blinky-lite-archive/blinky-fridge-mon-cube/schematics/cubeSchem/blinky-refrig-mon-cube.kicad_pcb

## KiCad design schematics/cubeSchem/blinky-refrig-mon-cube.kicad_pcb (2022-01-05)

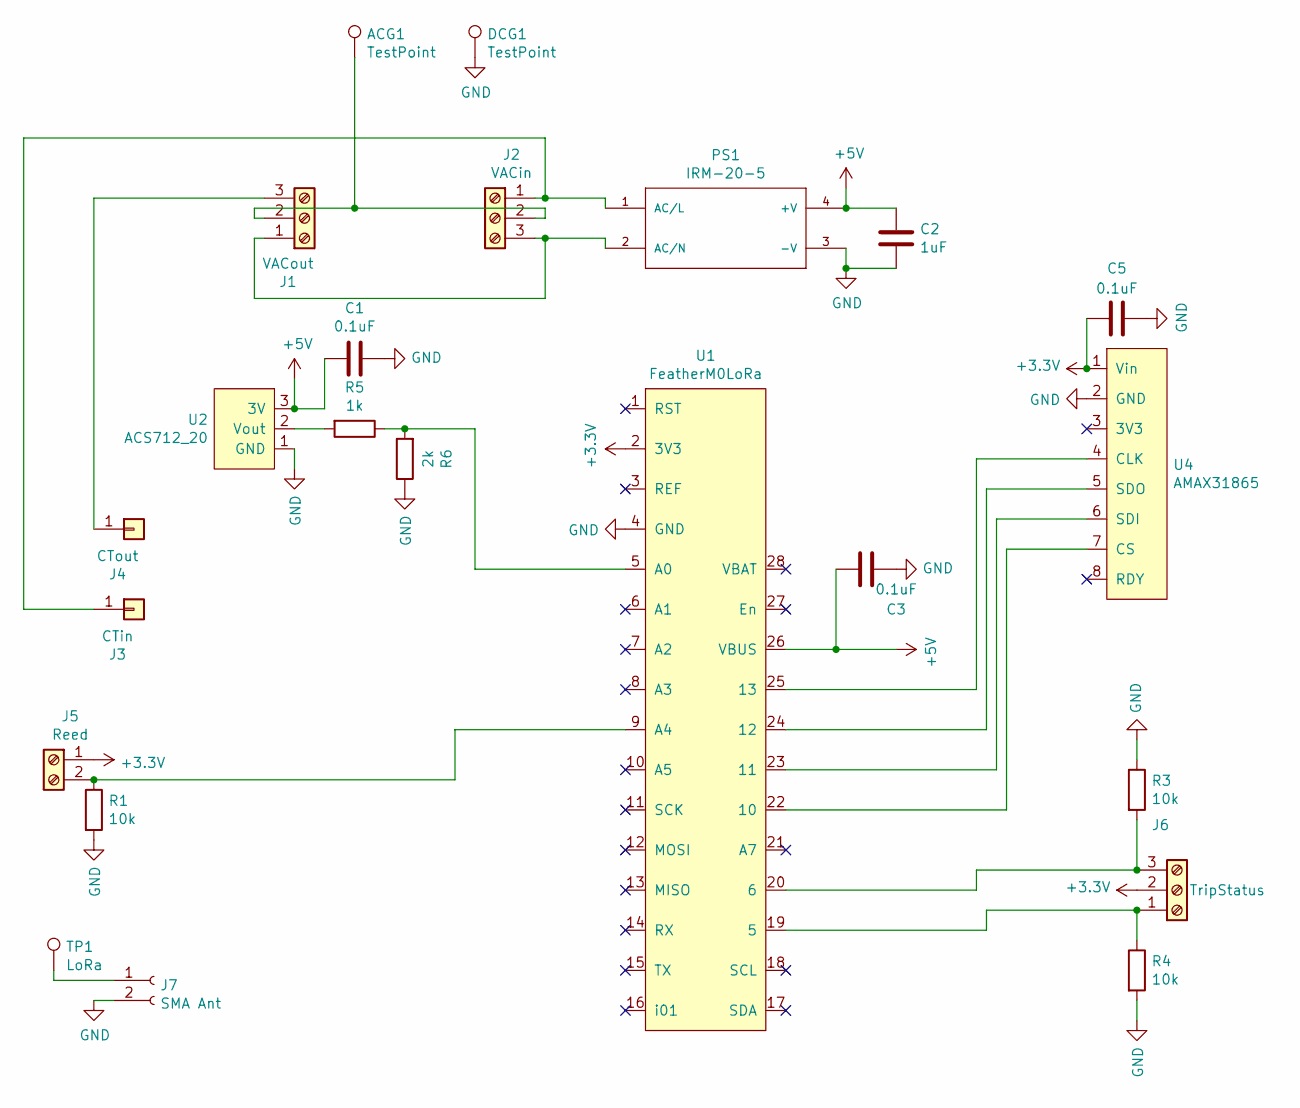
[picture p1: schematic blinky-refrig-mon-cube.sch]

Parts:
ACG1: TestPoint; TestPoint_THTPad_3.0x3.0mm_Drill1.5mm
C1, C3, C5: 0.1uF; C_1206_3216Metric_Pad1.42x1.75mm_HandSolder
C2: 1uF; C_1206_3216Metric_Pad1.42x1.75mm_HandSolder
DCG1: TestPoint; TestPoint_THTPad_3.0x3.0mm_Drill1.5mm
J1: VACout; TerminalBlock_bornier-3_P5.08mm
J2: VACin; TerminalBlock_bornier-3_P5.08mm
J3: CTin; SolderWirePad_1x01_Drill1.5mm
J4: CTout; SolderWirePad_1x01_Drill1.5mm
J5: Reed; TerminalBlock_bornier-2_P5.08mm
J6: TripStatus; TerminalBlock_bornier-3_P5.08mm
J7: SMA Ant; SMA_pcb
PS1: IRM-20-5; CONV_IRM-20-5
R1, R3, R4: 10k; R_1206_3216Metric_Pad1.42x1.75mm_HandSolder
R5: 1k; R_1206_3216Metric_Pad1.42x1.75mm_HandSolder
R6: 2k; R_1206_3216Metric_Pad1.42x1.75mm_HandSolder
TP1: LoRa; TestPoint_Plated_Hole_D2.0mm
U1: FeatherM0LoRa
U2: ACS712_20; ACS712_20A
U4: AMAX31865

Connections:
+3V3: C5.2, J5.1, J6.2, U1.2 (3V3), U4.1 (Vin)
+5V: C1.2, C2.1, C3.2, PS1.4 (+V), U1.26 (VBUS), U2.3 (3V)
GND: C1.1, C2.2, C3.1, C5.1, DCG1.1, J7.2, PS1.3 (-V), R1.2, R3.1, R4.2, R6.1, U1.4 (GND), U2.1 (GND), U4.2 (GND)
unnamed: ACG1.1, J1.2, J2.2
unnamed: J1.1, J2.3, PS1.2 (AC/N)
unnamed: J1.3, J4.1
unnamed: J2.1, J3.1, PS1.1 (AC/L)
unnamed: J5.2, R1.1, U1.9 (A4)
unnamed: J6.1, R4.1, U1.19 (5)
unnamed: J6.3, R3.2, U1.20 (6)
unnamed: J7.1, TP1.1
unnamed: R5.1, R6.2, U1.5 (A0)
unnamed: R5.2, U2.2 (Vout)
unnamed: U1.22 (10), U4.7 (CS)
unnamed: U1.23 (11), U4.6 (SDI)
unnamed: U1.24 (12), U4.5 (SDO)
unnamed: U1.25 (13), U4.4 (CLK)

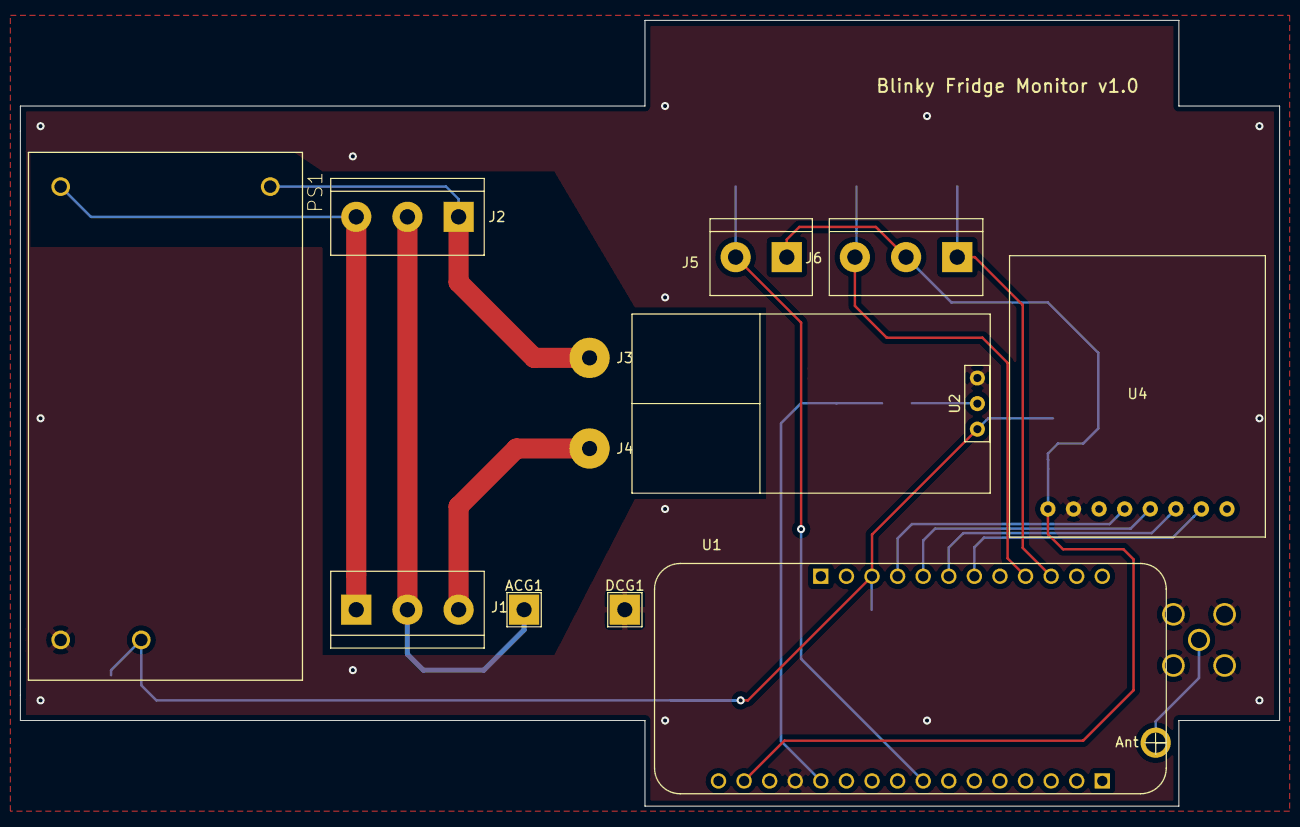
[picture p2: board blinky-refrig-mon-cube.kicad_pcb from above]

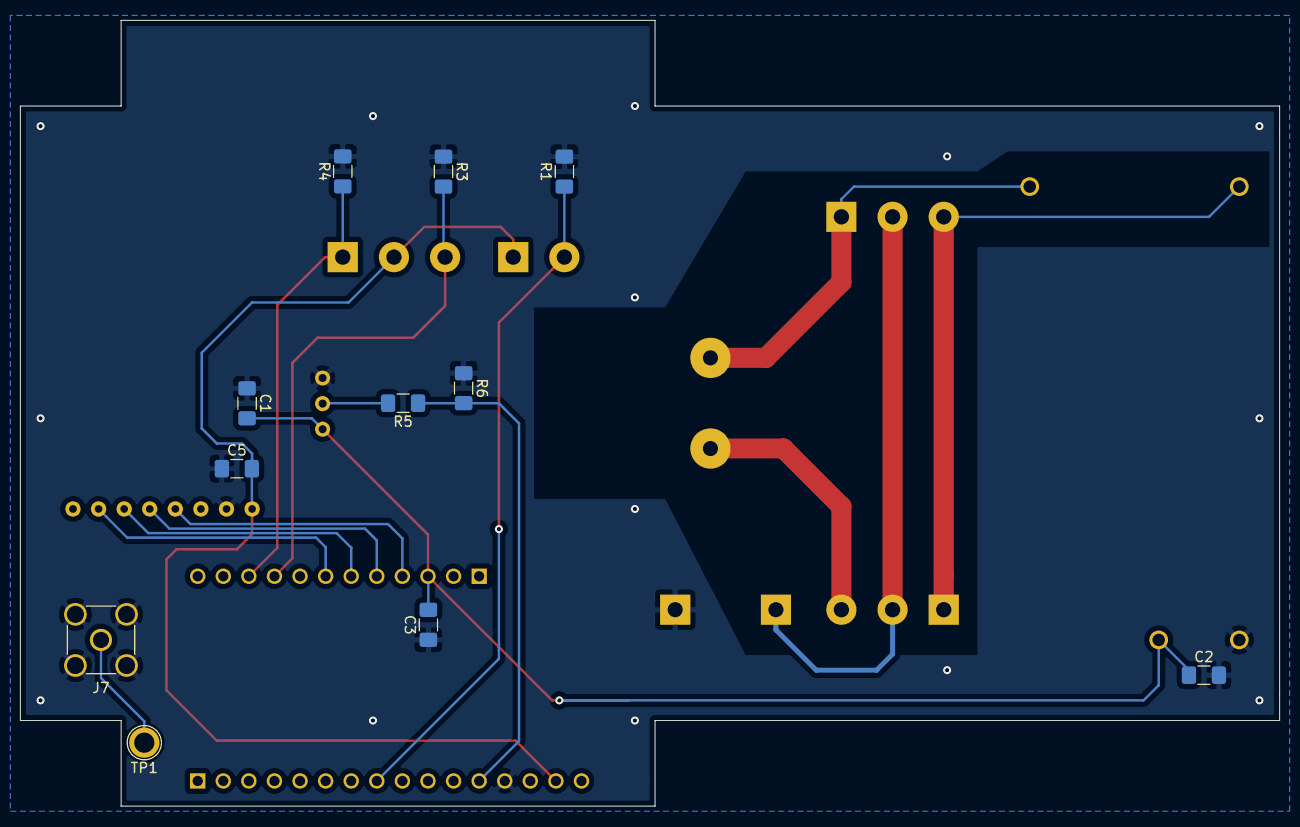
[picture p3: board blinky-refrig-mon-cube.kicad_pcb from below]

Board: 2 copper layers, 125.0 x 78.0 mm, 23 parts (11 on the bottom side), 17 nets.
