blinky-lite-archive/blinky-fridge-mon-cube/schematics/cubeLinkSchem/blinky-lora-link-cube.kicad_pcb

## KiCad design schematics/cubeLinkSchem/blinky-lora-link-cube.kicad_pcb (2022-01-05)

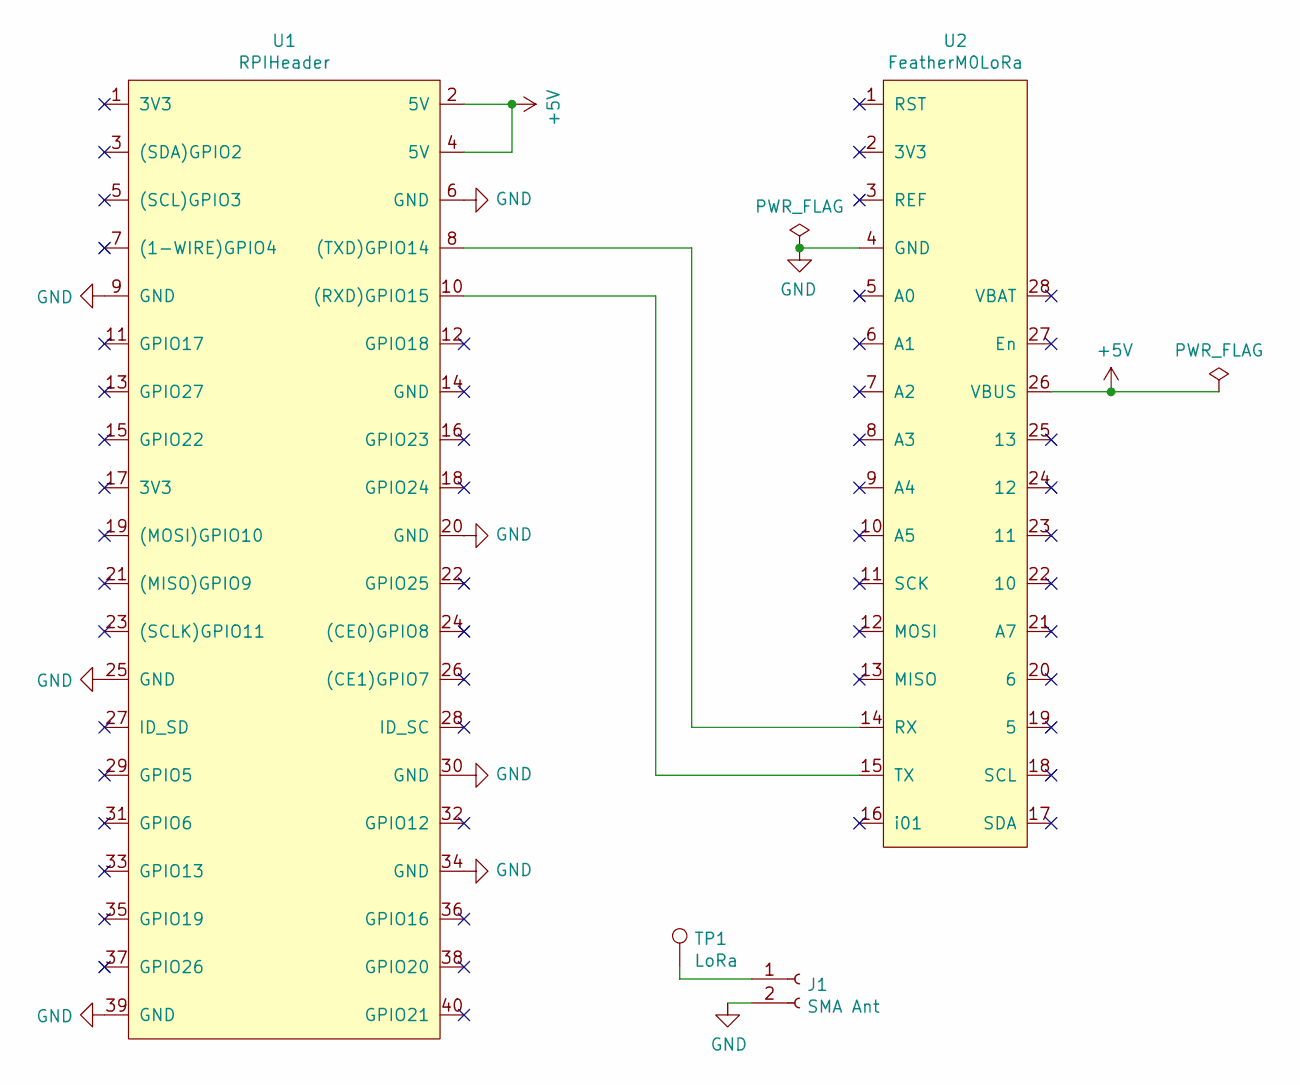
[picture p4: schematic blinky-lora-link-cube.sch]

Parts:
J1: SMA Ant; SMA_pcb
TP1: LoRa; TestPoint_Plated_Hole_D2.0mm
U1: RPIHeader; PinHeader_2x20_P2.54mm_Vertical
U2: FeatherM0LoRa

Connections:
+5V: U1.2 (5V), U1.4 (5V), U2.26 (VBUS)
GND: J1.2, U1.6 (GND), U1.9 (GND), U1.20 (GND), U1.25 (GND), U1.30 (GND), U1.34 (GND), U1.39 (GND), U2.4 (GND)
unnamed: J1.1, TP1.1
unnamed: U1.8 ((TXD)GPIO14), U2.14 (RX)
unnamed: U1.10 ((RXD)GPIO15), U2.15 (TX)

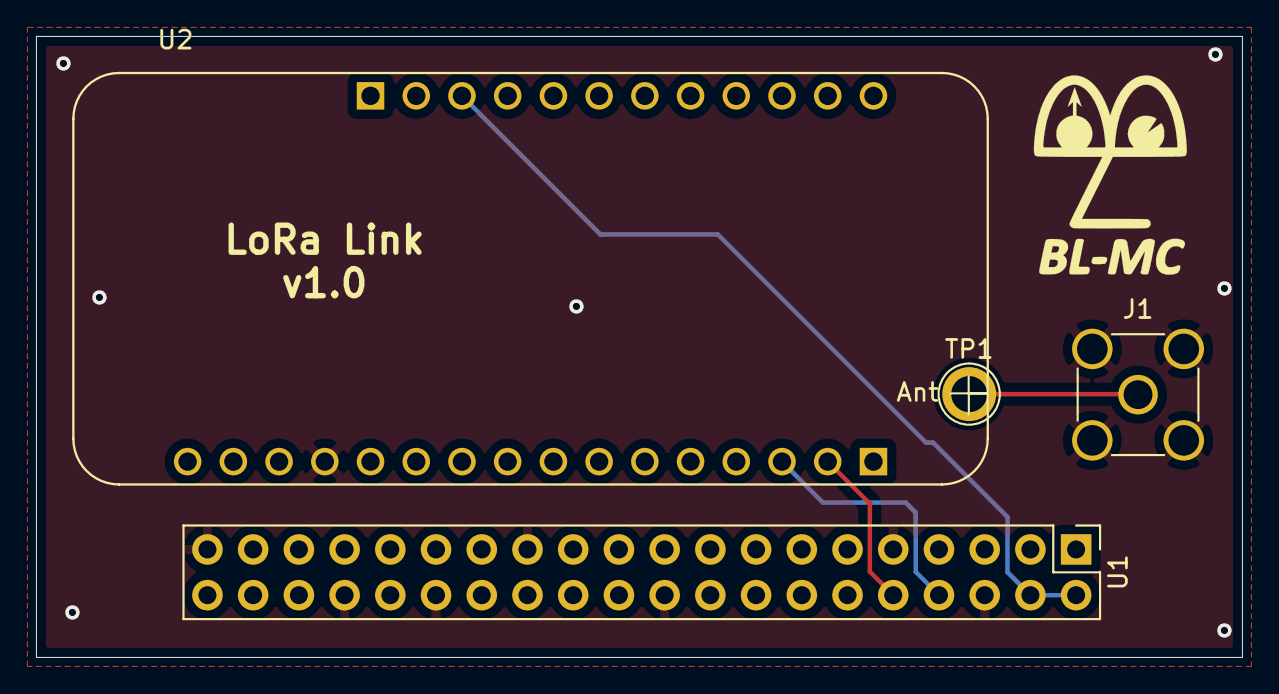
[picture p5: board blinky-lora-link-cube.kicad_pcb from above]

Board: 2 copper layers, 67.0 x 34.5 mm, 4 parts (0 on the bottom side), 5 nets.
