blinky-lite-archive/blinky-fridge-mon-cube/(commit log)

2020-03-22 updated schematic
    [blinky-lite-basic.kicad_pcb, blinky-lite-basic.sch, blinky-lite-basicBom.csv, off-n-on.kicad_pcb, off-n-on.sch]
2020-04-01 added soft 50Hz LPF
2021-09-20 mon and link layout done
    [blinky-lora-link-cube.kicad_pcb, blinky-lora-link-cube.sch, blinky-power-mon-cube.kicad_pcb, blinky-power-mon-cube.sch, off-n-on.kicad_pcb, off-n-on.sch]
2021-09-25 added logo
    [blinky-power-mon-cube.kicad_pcb]
2021-12-13 8 device generic link cube
2021-12-30 updating power-mon-schem
    [blinky-power-mon-cube.kicad_pcb, blinky-power-mon-cube.sch]
2022-01-04 laying out pcb for temp mon
    [blinky-power-mon-cube.kicad_pcb]
2022-01-04 pcb design seems finished
    [blinky-power-mon-cube.kicad_pcb, blinky-power-mon-cube.sch]
2022-01-04 updated cube code for current meas
2022-01-04 renamed schem files
    [blinky-refrig-mon-cube.kicad_pcb, blinky-refrig-mon-cube.sch]
2022-01-05 fixed lora footprint
    [blinky-lora-link-cube.kicad_pcb, blinky-lora-link-cube.sch, blinky-refrig-mon-cube.kicad_pcb, blinky-refrig-mon-cube.sch]
